NihilisticKirby/proyectoPIM_2022/Templates/Requirements-Traceability-Template.docx

REQUIREMENTS TRACEABILITY MATRIX

Project Name | Wireless Rear Derailleur | Date | August 24, 2022
Project Number | 0X | Document Number | 01
Project Manager | Ian Huerta | Project Owner/Client | MR3016

ID Number | Date Rec’vd | Source | Requirement Name and Description | WBS Deliverable | Assigned To | Acceptance Criteria | Tested By and Date | Accepted By and Date
001 | | | Tension range | Value | Ian | Complete
002 | | | Motor | Model n. Provider
003 | | | Microcontroller | Model n. Provider
004 | | | Rx and Tx | Model n. Provider
005 | | | Gearing | Proposals
| | | CAD
| | | FEA
| | | Power | Battery Circuit
| | | Shifting Transmission | Working
| | | Case I | Model Manufacturing Assy
| | | Shifting Buttons | Working
| | | Case II | Model Manufacturing Assy
| | | Assembly | Working

For additional project management templates visit http://www.mypmllc.com/project-management-resources/free-project-management-templates

Requirements Traceability Matrix Template 1
