NihilisticKirby/proyectoPIM_2022/Diagram.pptx

2.4GHz 4-channel transmitter

2.4GHz 4-channel transmitter

Up button

Down button

Left button

Right button

Increase pre-tension

Reduce pre-tension

Microcontroller

Driver

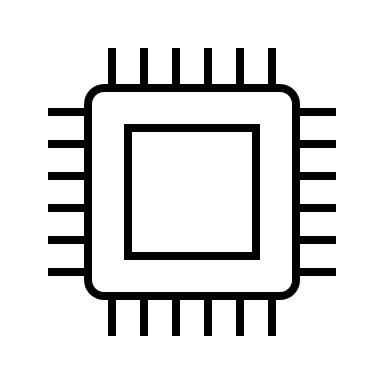
[picture p1: figure]
Processor outline

Model TBD

Motor

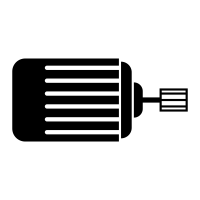
[picture p2: figure]

Shift lower

Tx

Rx

Rx

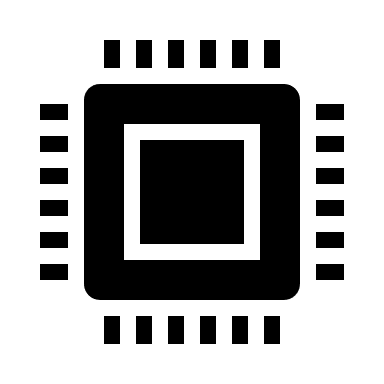
[picture p3: figure]
Processor with solid fill

Inputs

Outputs

Shift higher

5V

Optional
Gearing

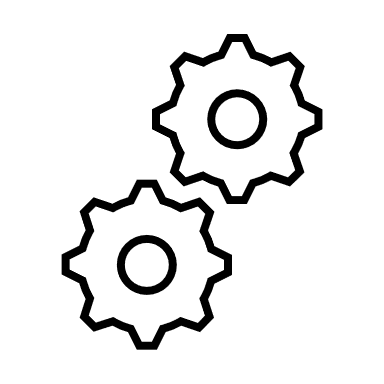
[picture p4: figure]
Gears outline
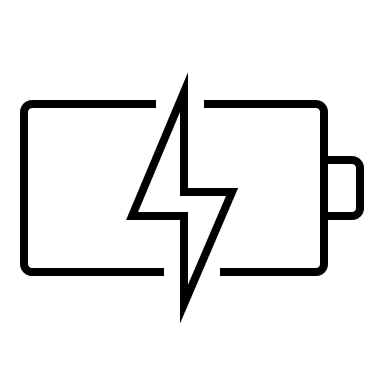
[picture p5: figure]
Battery charging outline

Power management

3V CR2025 Battery

3V CR2025 Battery

Battery
Model TBD

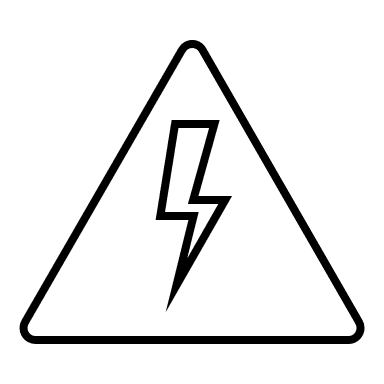
[picture p6: figure]
High voltage outline

(5V)

Shifter Controller Module

Cable

Shifting Module

Stock Derailleur
