NihilisticKirby/proyectoPIM_2022/Archived/Gantt.pdf

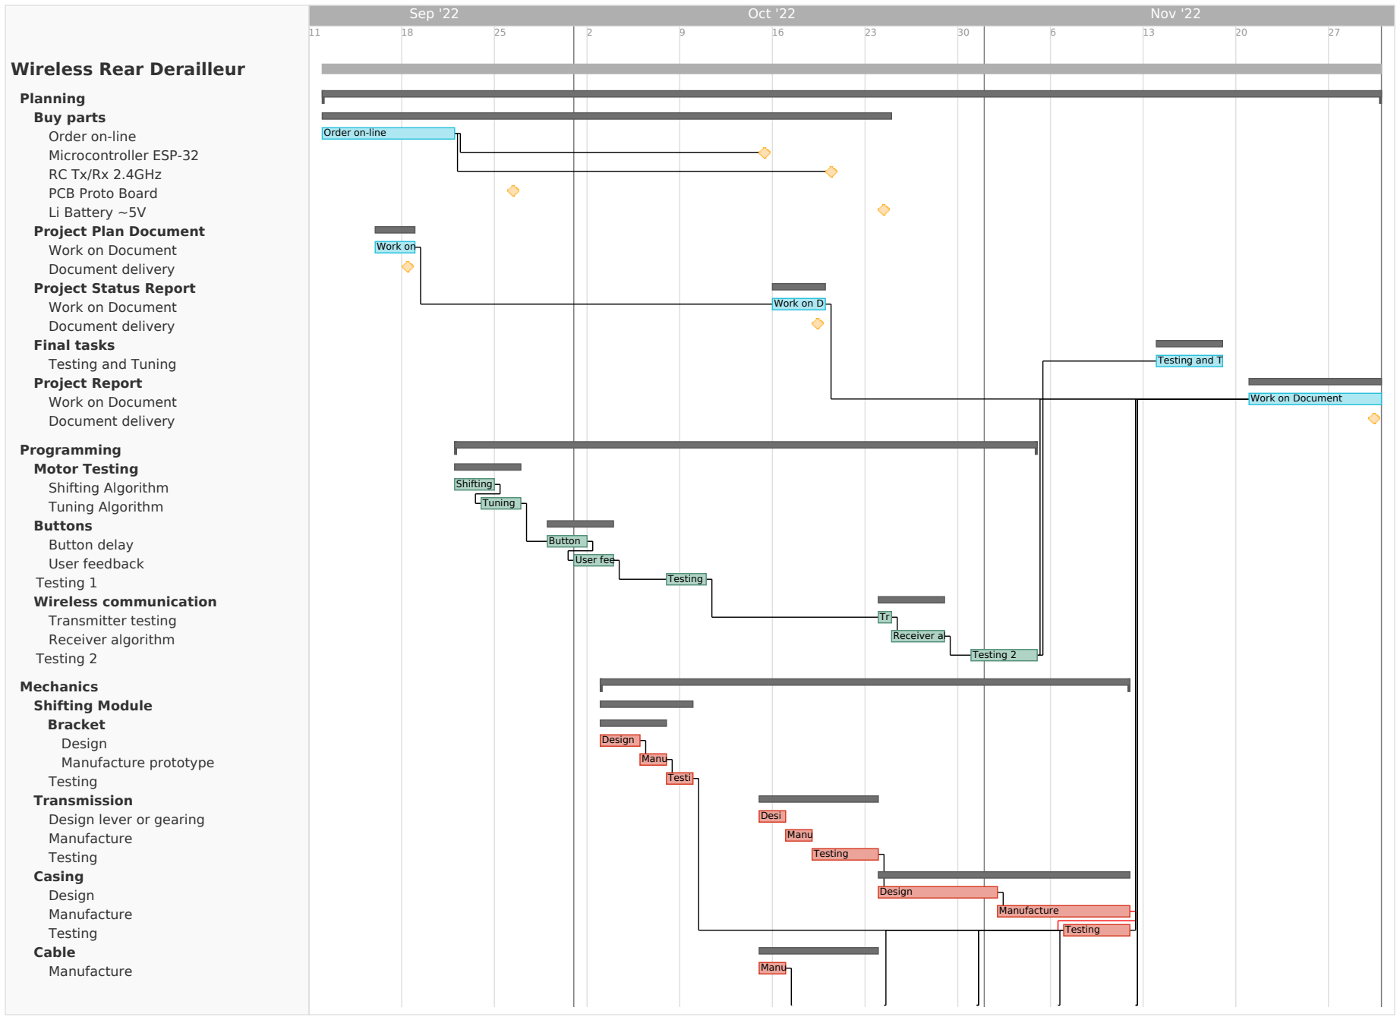
[picture p38: figure]
Sep '22; Oct '22; Nov '22; Wireless Rear Derailleur; Planning Buy parts Order on-line Microcontroller ESP-32 RC Tx/Rx 2.4GHz PCB Proto Board Li Battery ~5V Project Plan Document Work on Document Document delivery Project Status Report Work on Document Document delivery Final tasks Testing and Tuning Project Report Work on Document Document delivery; Programming Motor Testing Shifting Algorithm Tuning Algorithm Buttons Button delay User feedback Testing 1 Wireless communication Transmitter testing Receiver algorithm Testing 2; Mechanics Shifting Module Bracket Design Manufacture prototype Testing Transmission Design lever or gearing Manufacture Testing Casing Design Manufacture Testing Cable Manufacture; Order on-line; Work on; Work on D; Testing and T; Work on Document; Shifting; Tuning; Button; User fee; Testing; Receiver al; Testing 2; Design; Manu; Testi; Desi; Manufacture

Powered by TCPDF (www.tcpdf.org)

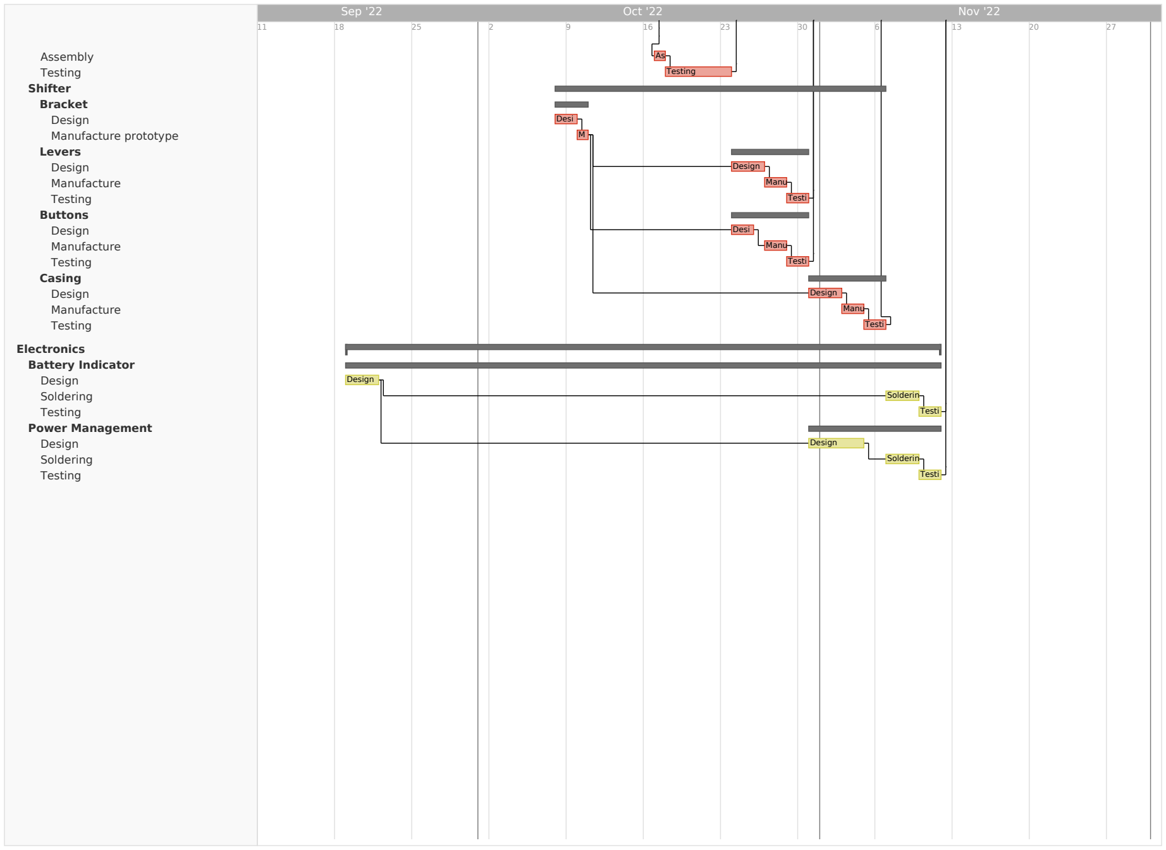
[picture p39: figure]
Sep '22; Oct '22; Nov '22; Assembly Testing Shifter Bracket Design Manufacture prototype Levers Design Manufacture Testing Buttons Design Manufacture Testing Casing Design Manufacture Testing; Electronics Battery Indicator Design Soldering Testing Power Management Design Soldering Testing; Testing; Desi; Design; Manu; Testi; Solderin
