NihilisticKirby/proyectoPIM_2022/SolidWorks/Drawings/MAIN_PLATE.JPG

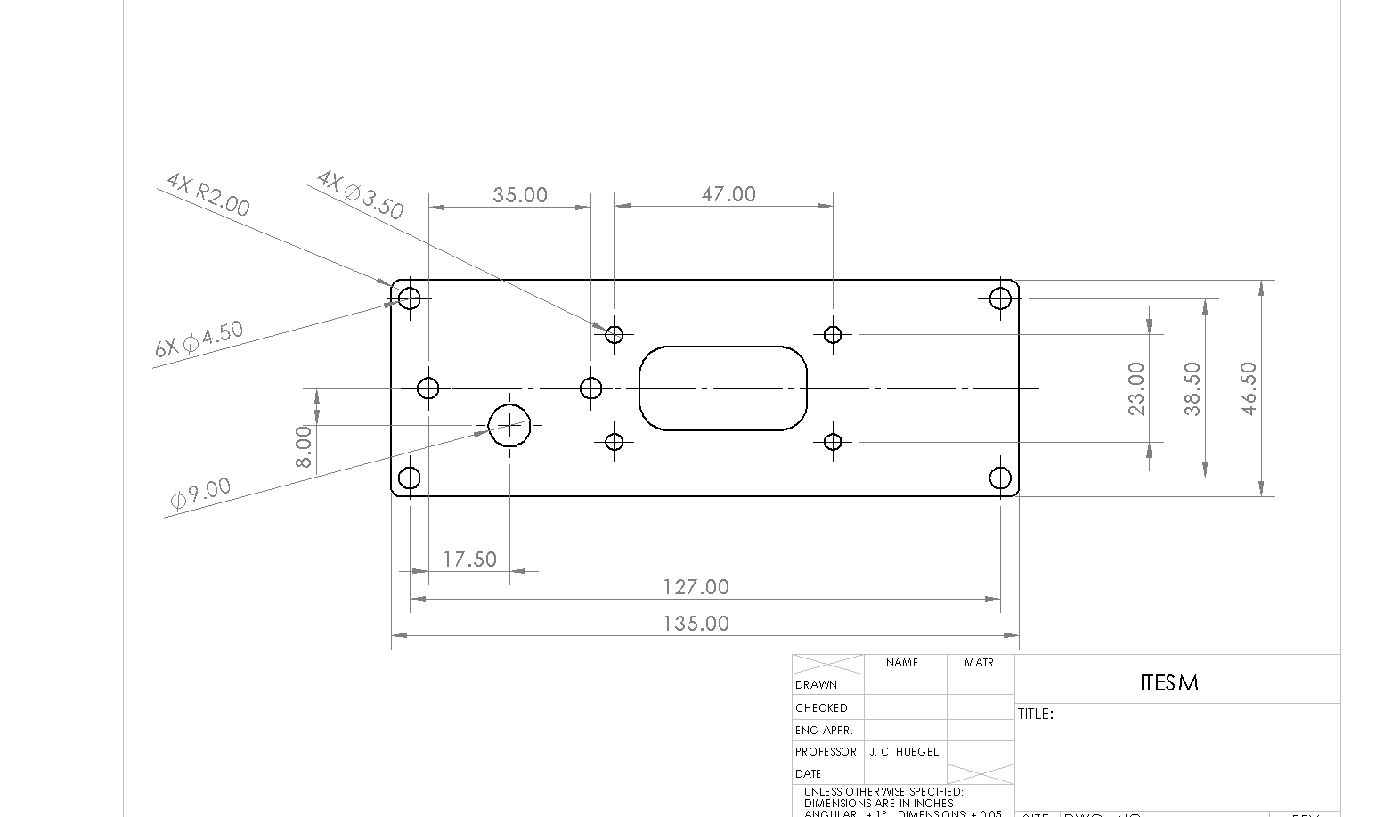
SolidWorks/Drawings/MAIN_PLATE.JPG
