NihilisticKirby/proyectoPIM_2022/SolidWorks/Drawings/SC_BRACKET.JPG

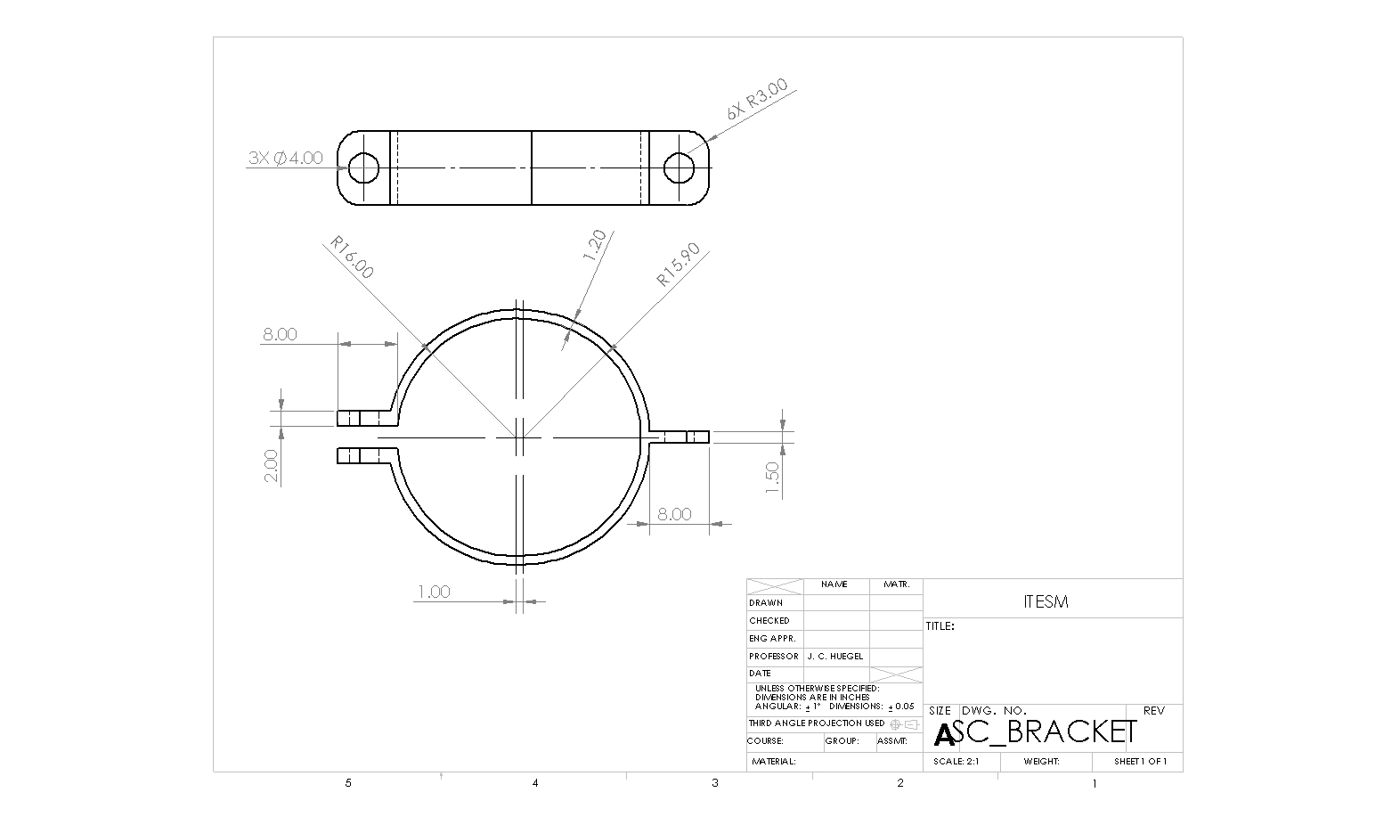
SolidWorks/Drawings/SC_BRACKET.JPG
