NihilisticKirby/proyectoPIM_2022/Templates/Requirements_Traceability_Matrix_Template.xls

Sheet: Instructions
 | For detail regarding the practice of Requirements Management, please refer to the Requirements Management Practices Guide
Instructions For Completing This Document
1.) | Complete the Project Name, C/I/O, Project Manager Name, and Project Description fields
2.) | For each issue identified, complete the following:
 | ID: A unique ID number used to identify the traceability item in the requirements traceability matrix.
 | Associated ID(s): This column should contain the ID of any associated utilities used for requirements tracking such as a repository, pipeline document, etc.
 | Technical Assumption(s) or Customer Need(s): This column should be populated with a description of the technical assumption or customer need linked to the functional requirement.
 | Functional Requirement: This column should be populated with a description of the functional requirement.
 | Status: This column should be populated with the current status of the functional requirement.
 | Architectural/Design Document: This column should be populated with a description of the architectural/design document linked to the functional requirement.
 | Technical Specification: This column should be populated with a description of the technical specification linked to the functional requirement.
 | System Component(s): This column should be populated with a description of the system component(s) linked to the functional requirement.
 | Software Module(s): This column should be populated with a description of the software module(s) linked to the functional requirement.
 | Test Case Number: This column should be populated with the test case number linked to the functional requirement.
 | Tested In: This column should be populated with the module that the functional requirement has been tested in.
 | Implemented In: This column should be populated with the module that the functional requirement has been implemented in.
 | Verification: This column should be populated with a description of the verification document linked to the functional requirement.
 | Additional Comments: This column should be populated with any additional comments
 | Source: https://www2a.cdc.gov/cdcup/library/templates/CDC_UP_Requirements_Traceability_Matrix_Template.xls

Sheet: Requirement_Traceability_Matrix
REQUIREMENTS TRACEABILITY MATRIX |  |  |  |  |  |  |  | REQUIREMENTS TRACEABILITY MATRIX
Project Name: |  | <optional> |  |  |  |  |  | Project Name: |  | <optional>
National Center: |  | <required> |  |  |  |  |  | National Center: |  | <required>
Project Manager Name: |  | <required> |  |  |  |  |  | Project Manager Name: |  | <required>
Project Description: |  | <required> |  |  |  |  |  | Project Description: |  | <required>
ID | Assoc ID | Technical Assumption(s) and/or Customer Need(s) | Functional Requirement | Status | Architectural/Design Document | Technical Specification | System Component(s) | Software Module(s) | Test Case Number | Tested In | Implemented In | Verification | Additional Comments
001 | 1.1.1
002 | 2.2.2
003 | 3.3.3
004 | 4.4.4
005 | 5.5.5
006
007
008
009
010
011
012
013
014
015
016
017
018
019
020
021
022
023
024
025
026
027
028
029
030
031
032
033
034
