NihilisticKirby/proyectoPIM_2022/Templates/Requirements_Matrix_example.xlsx

Sheet: Instructions
Instructions For Completing This Document
 | Complete the Project Name, Business Lead, IT Project Manager Name, Primary Segment Owner, and Project Description fields
 | For each issue identified, complete the following:
1 | ID: A unique ID number used to identify the traceability item in the requirements traceability matrix.
2 | Req. Def. ID: This column should contain the ID of the associated requirement as addressed in the Requirements Definition document.
3 | Associated ID(s): This column should contain the ID of any associated utilities used for requirements tracking such as a repository, pipeline document, etc.
4 | Technical Assumption(s) or Customer Need(s): This column should be populated with a description of the technical assumption or customer need linked to the functional requirement.
5 | Requirement Description: This column should be populated with a description of the functional requirement.
6 | Status: This column should be populated with the current status of the functional requirement.
7 | Status Date: The date the In-Progress status was last reported, or the testing or completed date.
8 | Type (Optional): Type of requirement.
9 | Priority: Priority of Requirement (Low, Medium, High).
10 | Assigned to: Person Requirement is assigned to.
11 | Architectural/Design Document: This column should be populated with a description of the architectural/design document linked to the functional requirement.
12 | Technical Specification: This column should be populated with a description of the technical specification linked to the functional requirement.
13 | System Component(s): This column should be populated with a description of the system component(s) linked to the functional requirement.
14 | Software Module(s): This column should be populated with a description of the software module(s) linked to the functional requirement.
15 | Test Case Number: This column should be populated with the test case number linked to the functional requirement.
16 | Tested In: This column should be populated with the module that the functional requirement has been tested in.
17 | Implemented In: This column should be populated with the module that the functional requirement has been implemented in.
18 | Verification: This column should be populated with a description of the verification document linked to the functional requirement.
19 | Additional Comments: This column should be populated with any additional comments
 | Source: https://www.hud.gov/sites/documents/req_trace2.xlsx

Sheet: Requirement_Traceability_Matrix
REQUIREMENTS TRACEABILITY MATRIX
Project Name: |  |  | <required>
Business Lead Name: |  |  | <required>
IT Project Manager Name: |  |  | <required>
Primary Segment Sponsor |  |  | <required>
ID | Req. Def. ID | Associated ID | Technical Assumption(s) and/or Customer Need(s)* | Requirement Description* | Status* | Status Date | Type (optional)* | Priority* | Assigned To* | Architectural/Design Document | Technical Specification | System Component(s) | Software Module(s) | Test Case Number | Tested In | Implemented In | Verification | Additional Comments | Functional | L
001 |  |  | Detección de peaton(es) | Cuando hay una identificación positiva, el vehículo empieza a frenar 5 metros antes | In Progress | 2018-02-01 | Functional | L | John Smith | Solution Architecture Documents | N/A | Hardware | N/A |  |  |  |  |  | Non-Functional | M
002 |  |  | Detección de peaton(es) | Indicador luminoso de detección de peatón |  |  |  |  |  |  |  |  |  |  |  |  |  |  | Security | H
003 |  |  | Detección de peaton(es) | Después de identificar peatón, el vehículo hace alto total a 1 metro
004 |  |  | Detección de obstáculos | Medición de obstáculos frontales en un rango de 10 metros
005 |  |  | Detección de obstáculos | Medición de obstáculos frontales con resolución de 50 cm
006 |  |  | Frenado automático | Frenado controlable en el rango de -n m/s2
007 |  |  | Alimentación de batería automotriz | Voltaje de entrada 12V DC
008
009
010
011
012
013
014
015
016
017
018
019
020
021
022
023
024
025
026
027
028
029
030
031
032
033
034
