NihilisticKirby/proyectoPIM_2022/SolidWorks/Assemblies/SHIFTING_MODULE.SLDASM

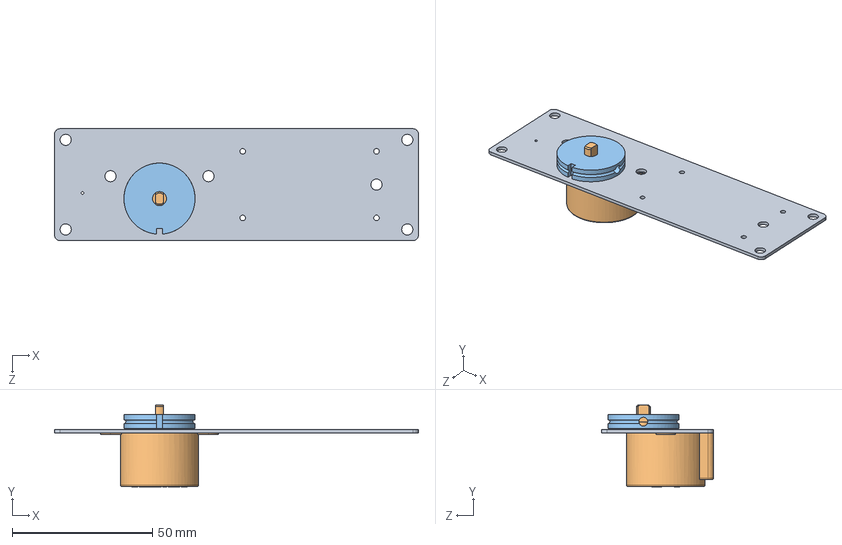
[picture p42: CAD file, 2022-11-30]
SolidWorks/Assemblies/SHIFTING_MODULE.SLDASM
130.0 x 29.2 x 40.1 mm
MAIN_PLATE
Stepper 28BYJ48
MOTOR_PULLEY
