NihilisticKirby/proyectoPIM_2022/SolidWorks/Assemblies/SHIFTING_MODULE_V2.SLDASM

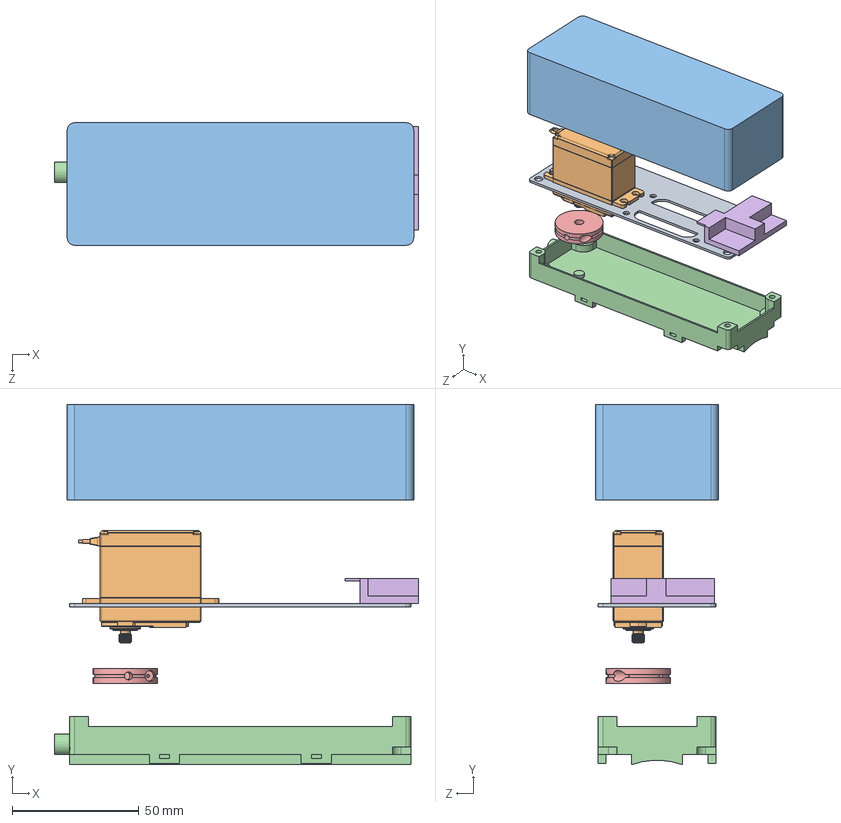
[picture p43: CAD file, 2022-11-30]
SolidWorks/Assemblies/SHIFTING_MODULE_V2.SLDASM
143.9 x 142.4 x 48.5 mm
MAIN_PLATE_V2
MG995
SM_UPPER
SM_LOWER
MOTOR_PULLEY
RECEIVER
