NihilisticKirby/proyectoPIM_2022/SolidWorks/Drawings/MAIN_PLATE_V2.DXF

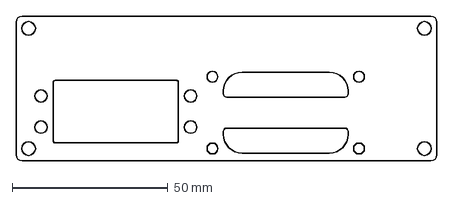
[picture p44: CAD file, 2022-11-30]
SolidWorks/Drawings/MAIN_PLATE_V2.DXF
135.0 x 46.5 mm
