NihilisticKirby/proyectoPIM_2022/SolidWorks/Parts/MAIN_PLATE.SLDPRT

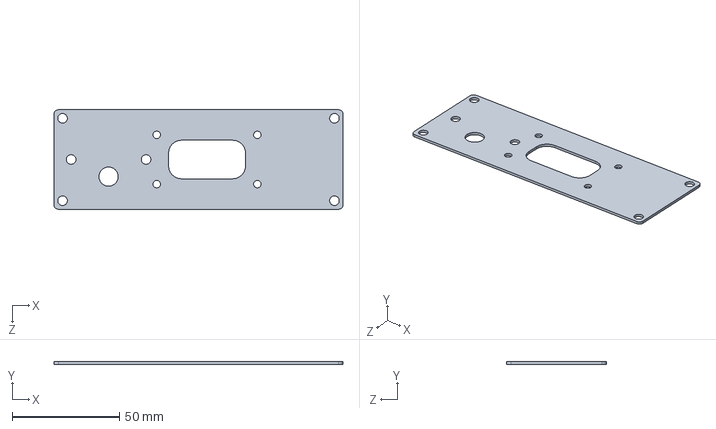
[picture p45: CAD file, 2022-11-30]
SolidWorks/Parts/MAIN_PLATE.SLDPRT
135.0 x 1.22 x 46.5 mm
