NihilisticKirby/proyectoPIM_2022/SolidWorks/Parts/Downloaded/Stepper 28BYJ48.SLDPRT

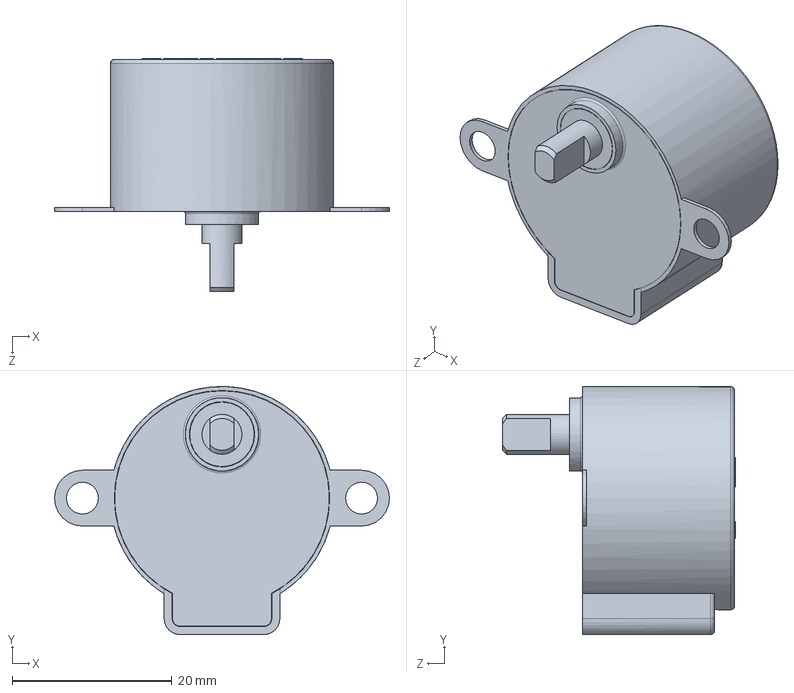
[picture p47: CAD file, 2022-11-30]
SolidWorks/Parts/Downloaded/Stepper 28BYJ48.SLDPRT
42.0 x 31.1 x 29.2 mm
