NihilisticKirby/proyectoPIM_2022/SolidWorks/Parts/SM_LOWER.SLDPRT

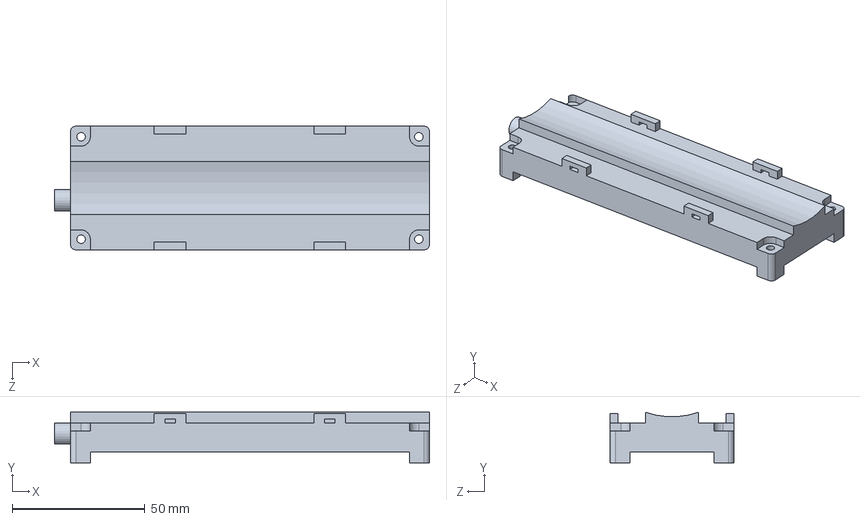
[picture p48: CAD file, 2022-12-01]
SolidWorks/Parts/SM_LOWER.SLDPRT
141.0 x 19.0 x 46.5 mm
