NihilisticKirby/proyectoPIM_2022/SolidWorks/Parts/Downloaded/MG995.STEP

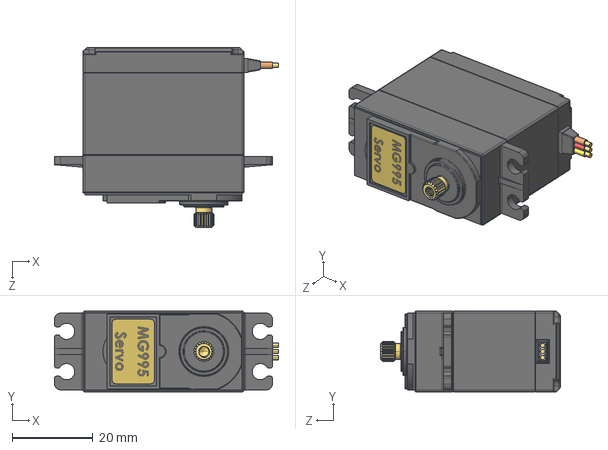
[picture p49: CAD file, 2022-11-30]
SolidWorks/Parts/Downloaded/MG995.STEP
55.5 x 20.0 x 44.5 mm
