NihilisticKirby/proyectoPIM_2022/SolidWorks/Parts/SM_UPPER.SLDPRT

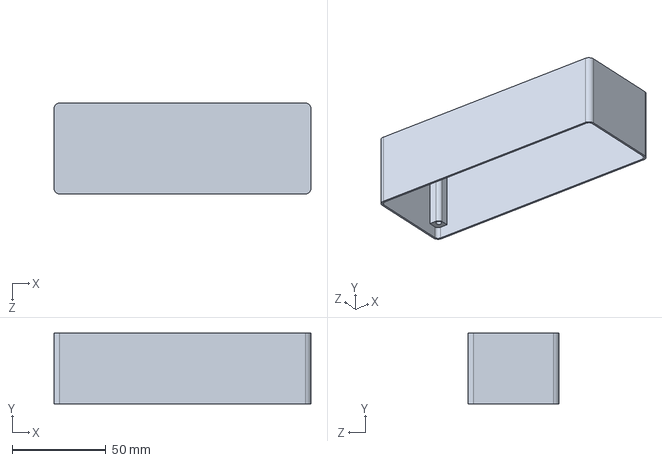
[picture p50: CAD file, 2022-12-01]
SolidWorks/Parts/SM_UPPER.SLDPRT
137.0 x 37.8 x 48.5 mm
