NihilisticKirby/proyectoPIM_2022/SolidWorks/Parts/CONTROLLER_BRACKET.SLDPRT

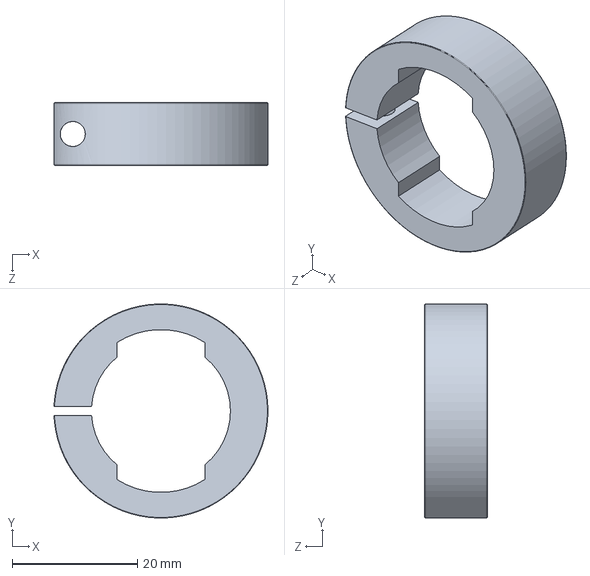
[picture p51: CAD file, 2022-12-01]
SolidWorks/Parts/CONTROLLER_BRACKET.SLDPRT
34.2 x 34.2 x 10.0 mm
