NihilisticKirby/proyectoPIM_2022/SolidWorks/Parts/MOTOR_PULLEY.SLDPRT

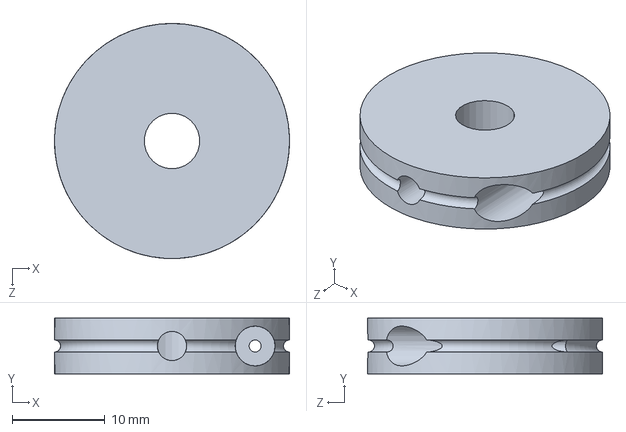
[picture p52: CAD file, 2022-12-01]
SolidWorks/Parts/MOTOR_PULLEY.SLDPRT
25.4 x 6.00 x 25.4 mm
