NihilisticKirby/proyectoPIM_2022/SolidWorks/Parts/CONTROLLER_CASE_B.SLDPRT

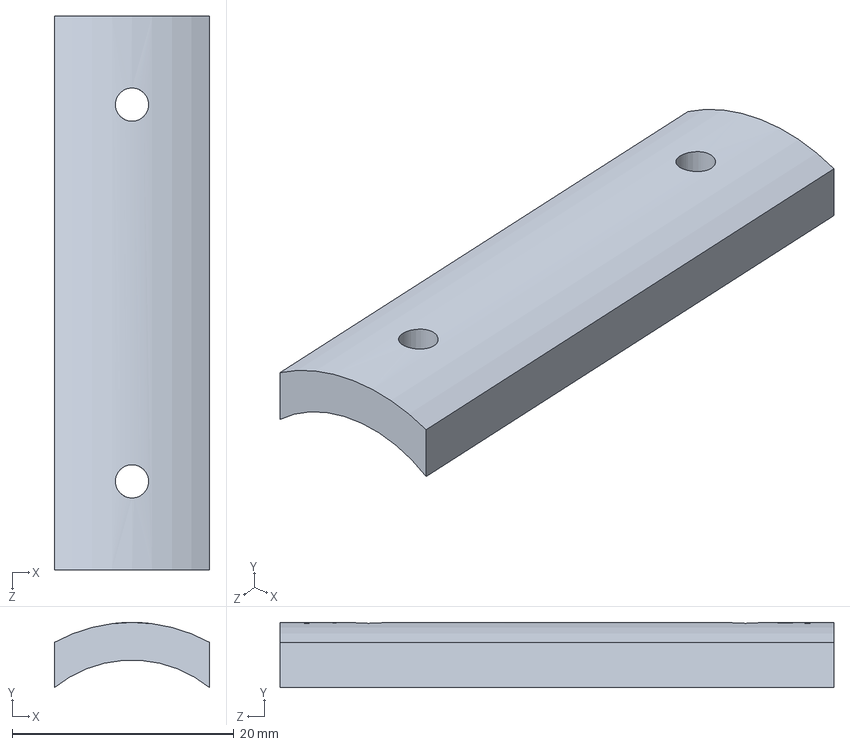
[picture p53: CAD file, 2022-11-30]
SolidWorks/Parts/CONTROLLER_CASE_B.SLDPRT
14.0 x 5.89 x 50.0 mm
