NihilisticKirby/proyectoPIM_2022/SolidWorks/Parts/PULLEY_GUIDE.SLDPRT

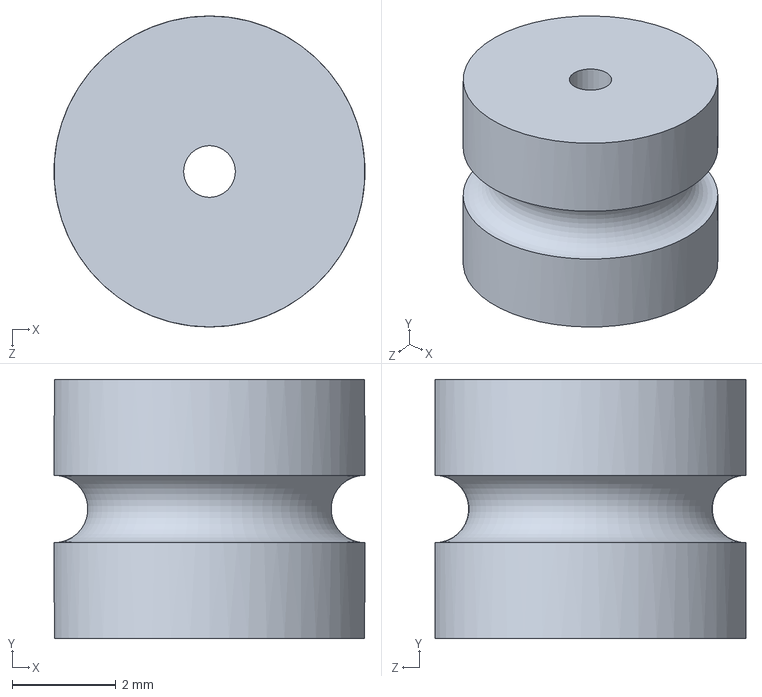
[picture p54: CAD file, 2022-11-30]
SolidWorks/Parts/PULLEY_GUIDE.SLDPRT
5.99 x 5.00 x 6.00 mm
