NihilisticKirby/proyectoPIM_2022/SolidWorks/Parts/RECEIVER.SLDPRT

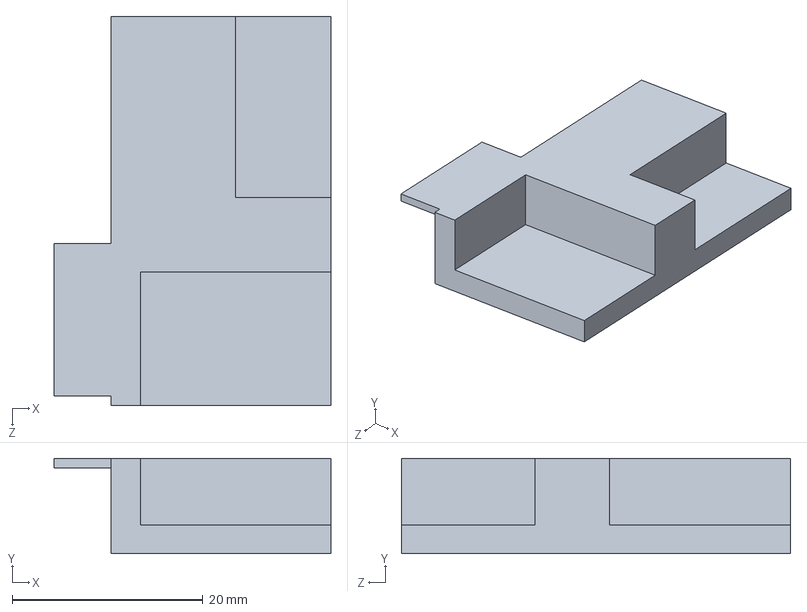
[picture p55: CAD file, 2022-11-30]
SolidWorks/Parts/RECEIVER.SLDPRT
29.1 x 10.0 x 40.8 mm
