NihilisticKirby/proyectoPIM_2022/SolidWorks/Parts/SC_BRACKET.SLDPRT

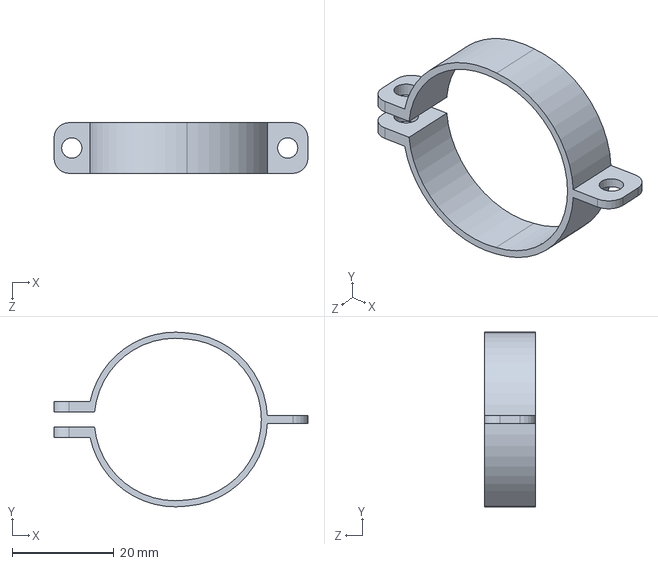
[picture p56: CAD file, 2022-11-30]
SolidWorks/Parts/SC_BRACKET.SLDPRT
50.0 x 34.4 x 10.0 mm
