NihilisticKirby/proyectoPIM_2022/(list of files, cad)

Other CAD files:
SolidWorks/Drawings/MAIN_PLATE.DWG
SolidWorks/3D/SM_LOWER.STL
SolidWorks/Drawings/CONTROLLER_BRACKET.SLDDRW
SolidWorks/Drawings/CONTROLLER_CASE_B.SLDDRW
SolidWorks/Drawings/MAIN_PLATE.SLDDRW
SolidWorks/Drawings/MAIN_PLATE_V2.DWG
SolidWorks/Drawings/MAIN_PLATE_V2.SLDDRW
SolidWorks/Drawings/MOTOR_PULLEY.SLDDRW
SolidWorks/Drawings/SC_BRACKET.SLDDRW
SolidWorks/Drawings/SM_LOWER.SLDDRW
SolidWorks/Drawings/SM_UPPER.SLDDRW
SolidWorks/Parts/Downloaded/MG995.IGS
SolidWorks/Parts/Downloaded/MG995.SLDPRT
SolidWorks/Parts/Downloaded/MG995.STL
