NihilisticKirby/proyectoPIM_2022/Figures/PowerManagementSystemCircuit.pdf

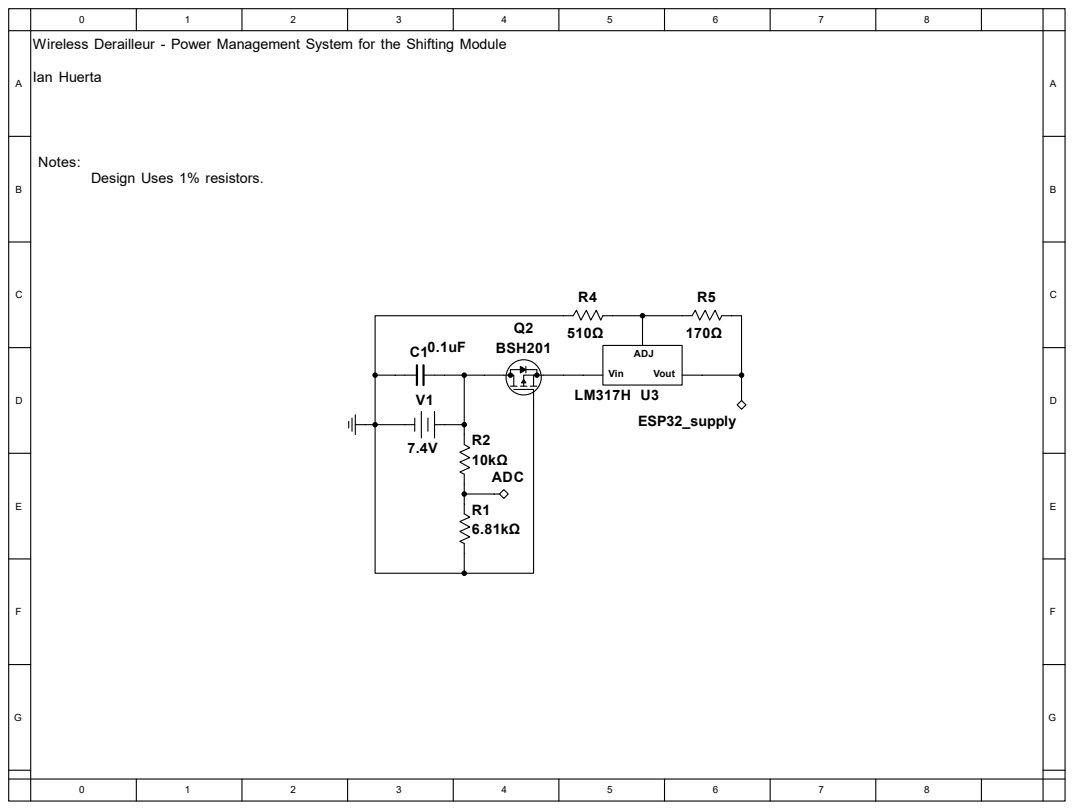
[picture p57: page 1]
Vout; ADJ; Vin; ADC; ESP32_supply; Notes:; Ian Huerta; Q2 BSH201

Wireless Derailleur - Power Management System for the Shifting Module

Design Uses 1% resistors.
