NihilisticKirby/proyectoPIM_2022/SolidWorks/Drawings/CONTROLLER_BRACKET.pdf

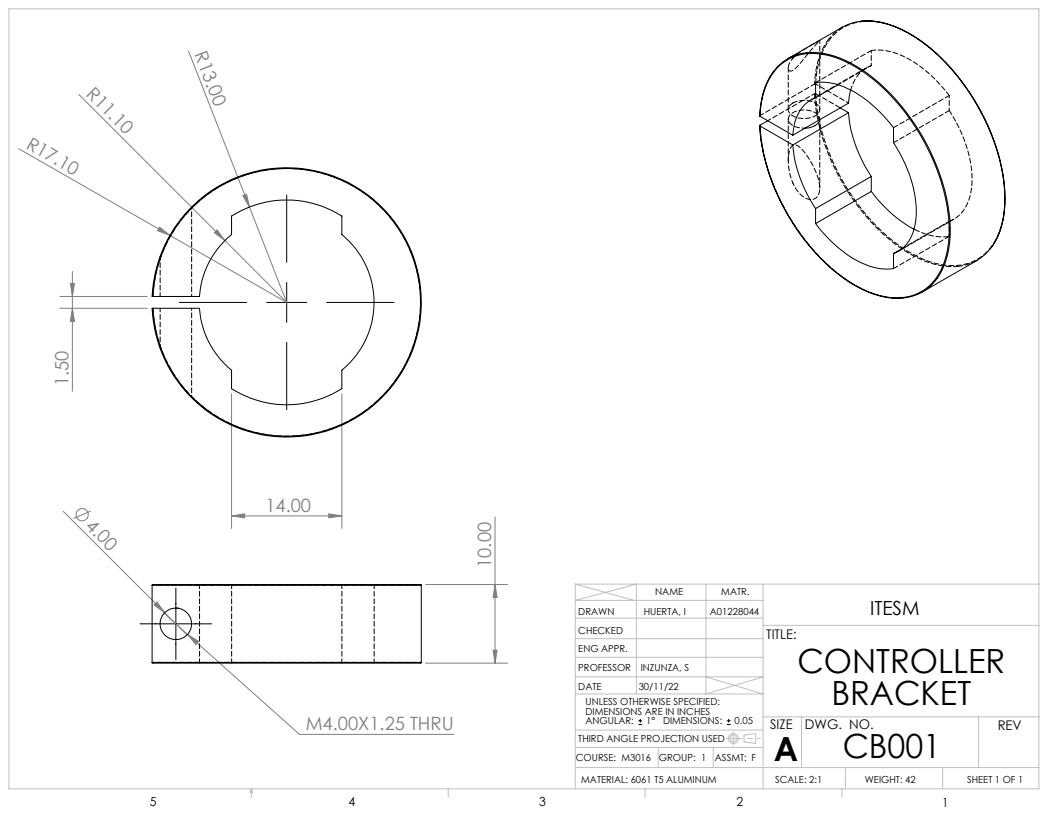
[picture p58: page 1]
M4.00X1.25 THRU; COURSE: M3016 GROUP: 1; F ASSMT:; INZUNZA, S; SCALE: 2:1; WEIGHT: 42; SHEET 1 OF 1; DWG. NO.; REV; DRAWN; HUERTA, I

CHECKED
ENG APPR.
PROFESSOR
UNLESS OTHERWISE SPECIFIED:
DIMENSIONS ARE IN INCHES
ANGULAR: 1° DIMENSIONS: 0.05
THIRD ANGLE PROJECTION USED
MATERIAL: 6061 T5 ALUMINUM
