NihilisticKirby/proyectoPIM_2022/SolidWorks/Drawings/CONTROLLER_CASE_B.pdf

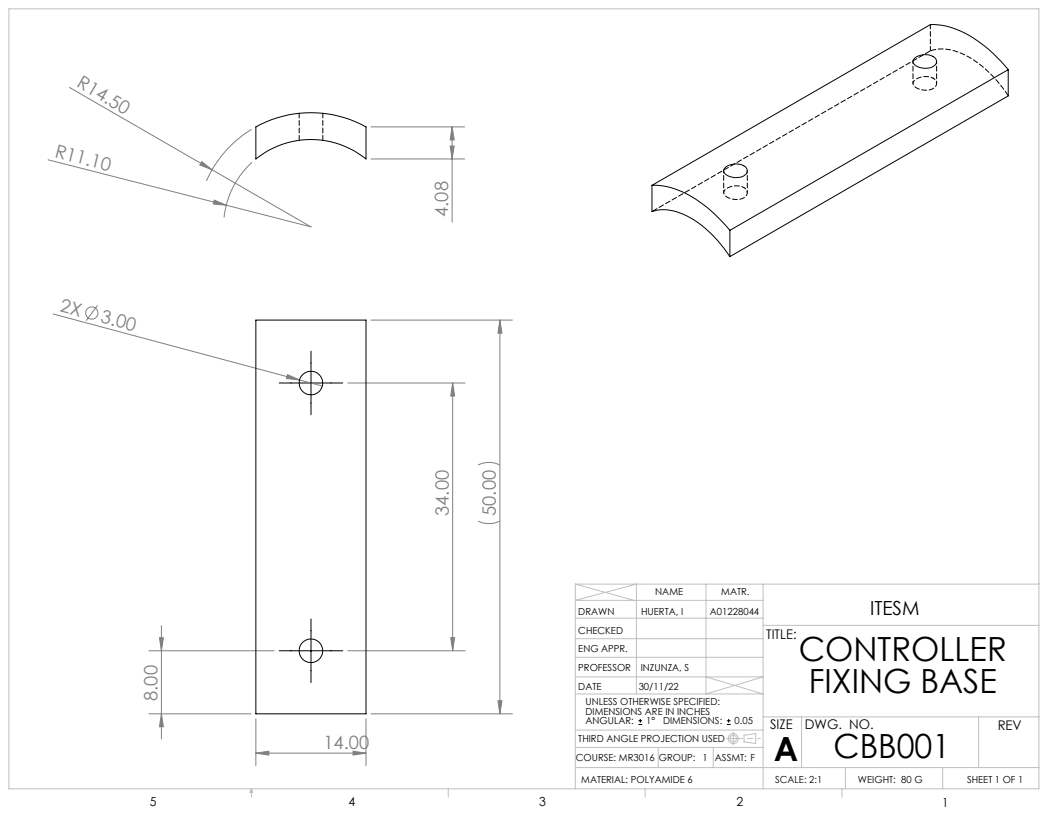
[picture p59: page 1]
COURSE: MR3016; F GROUP:; ASSMT:; INZUNZA, S; SCALE: 2:1; WEIGHT: 80 G; SHEET 1 OF 1; DWG. NO.; REV; DRAWN; HUERTA, I; FIXING BASE

CHECKED
ENG APPR.
PROFESSOR
UNLESS OTHERWISE SPECIFIED:
DIMENSIONS ARE IN INCHES
ANGULAR: 1° DIMENSIONS: 0.05
THIRD ANGLE PROJECTION USED
MATERIAL: POLYAMIDE 6
