NihilisticKirby/proyectoPIM_2022/SolidWorks/Drawings/MAIN_PLATE_V2.pdf

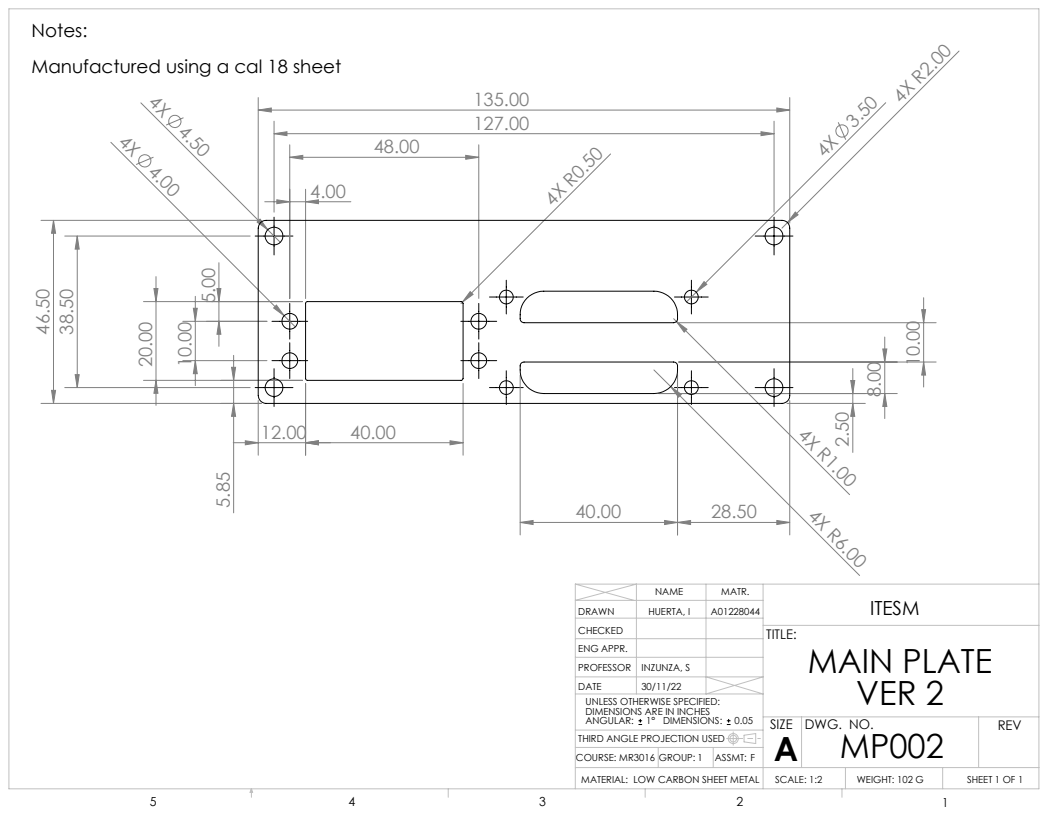
[picture p60: page 1]
COURSE: MR3016; F GROUP:; ASSMT:; SCALE: 1:2; WEIGHT: 102 G; SHEET 1 OF 1; DWG. NO.; REV; HUERTA, I; MAIN PLATE VER 2

Notes:
Manufactured using a cal 18 sheet

DRAWN
CHECKED
ENG APPR.
PROFESSOR INZUNZA, S
UNLESS OTHERWISE SPECIFIED:
DIMENSIONS ARE IN INCHES
ANGULAR: 1° DIMENSIONS: 0.05
THIRD ANGLE PROJECTION USED
MATERIAL: LOW CARBON SHEET METAL
