NihilisticKirby/proyectoPIM_2022/SolidWorks/Drawings/MOTOR_PULLEY.pdf

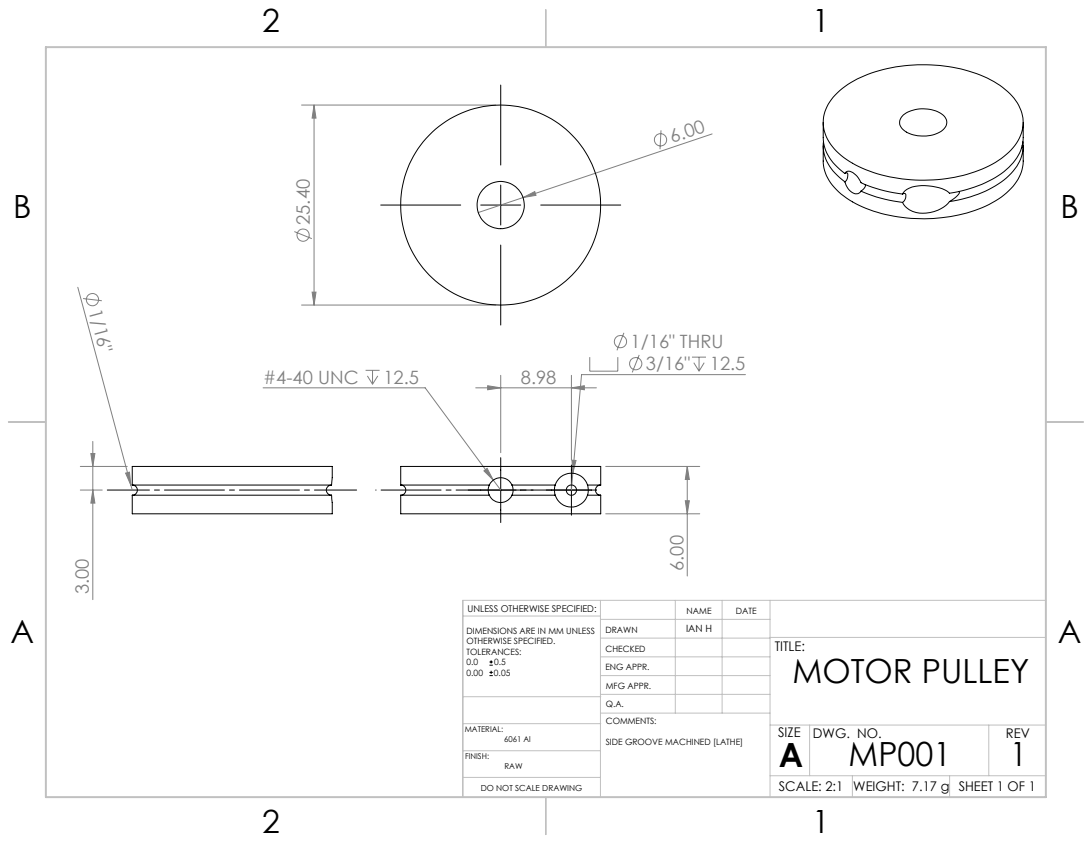
[picture p61: page 1]
#4-40 UNC 12.5; 1/16" THRU 3/16" 12.5; SHEET 1 OF 1; SCALE: 2:1; WEIGHT: 7.17 g; DWG. NO.; REV

UNLESS OTHERWISE SPECIFIED: | | NAME | DATE
DIMENSIONS ARE IN MM UNLESS OTHERWISE SPECIFIED. TOLERANCES: 0.0 0.5 0.00 0.05 | DRAWN | IAN H

CHECKED | | | TITLE: MOTOR PULLEY

ENG APPR.
MFG APPR.
Q.A.

COMMENTS:
SIDE GROOVE MACHINED [LATHE]

DO NOT SCALE DRAWING
