NihilisticKirby/proyectoPIM_2022/SolidWorks/Drawings/SM_LOWER.pdf

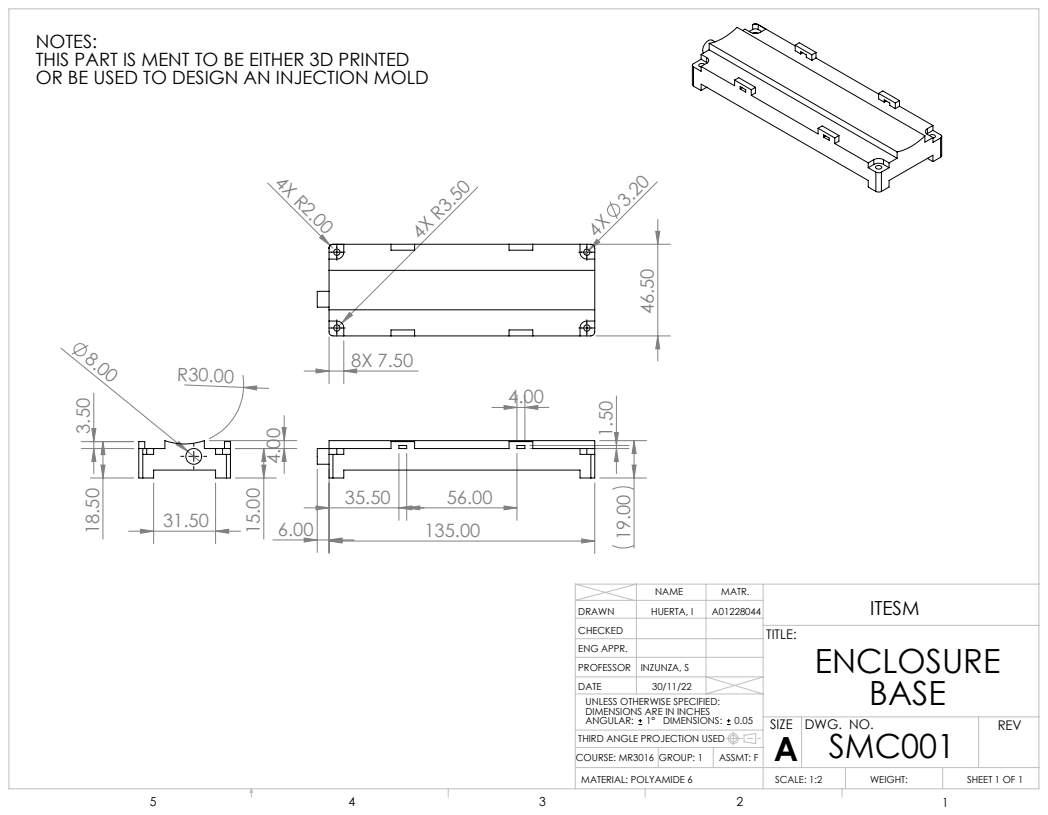
[picture p62: page 1]
COURSE: MR3016 GROUP: 1; ASSMT: F; INZUNZA, S; SCALE: 1:2; WEIGHT:; SHEET 1 OF 1; DWG. NO.; REV; HUERTA, I

NOTES:
THIS PART IS MENT TO BE EITHER 3D PRINTED
OR BE USED TO DESIGN AN INJECTION MOLD

DRAWN
CHECKED
ENG APPR.
PROFESSOR
DATE
UNLESS OTHERWISE SPECIFIED:
DIMENSIONS ARE IN INCHES
ANGULAR: 1° DIMENSIONS: 0.05
THIRD ANGLE PROJECTION USED
MATERIAL: POLYAMIDE 6
