NihilisticKirby/proyectoPIM_2022/SolidWorks/Drawings/SM_UPPER.pdf

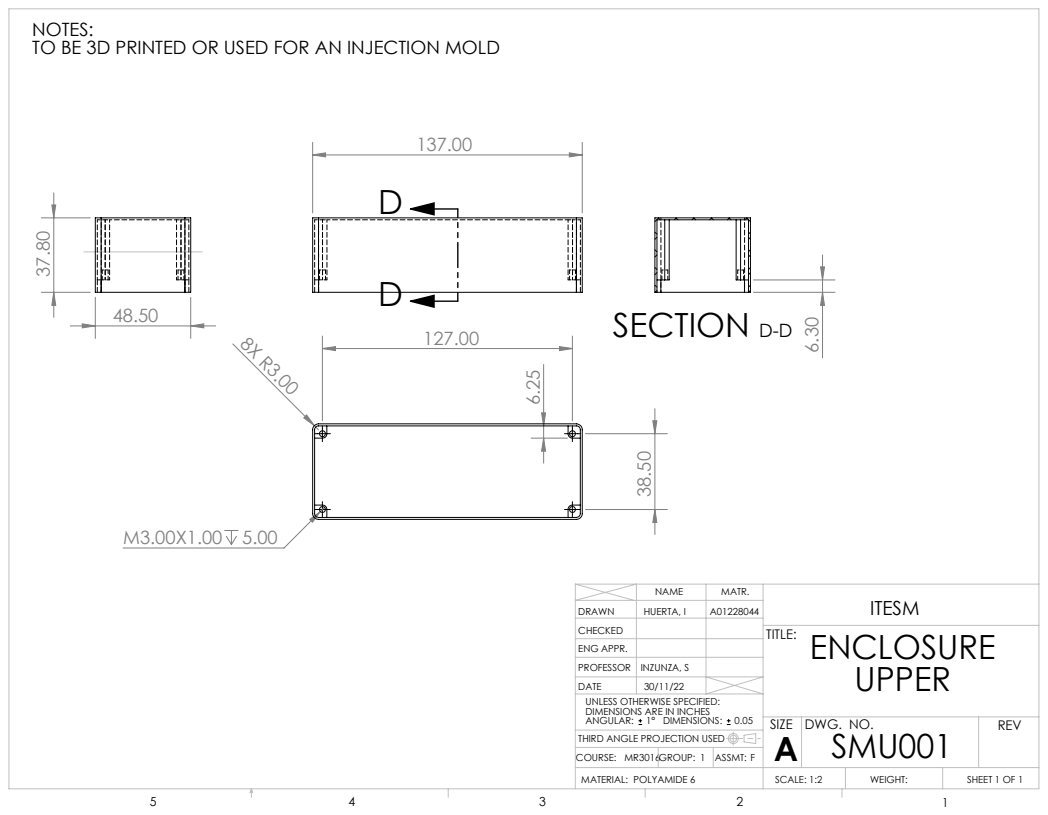
[picture p63: page 1]
SECTION D-D; COURSE: MR3016; F GROUP:; ASSMT:; INZUNZA, S; SCALE: 1:2; WEIGHT:; SHEET 1 OF 1; DWG. NO.; REV; DRAWN; HUERTA, I

NOTES:
TO BE 3D PRINTED OR USED FOR AN INJECTION MOLD

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
