NihilisticKirby/proyectoPIM_2022/(list of files, drawings)

Other design files:
Multisim/PMS.ms14
